Lee34667/PCB-KiCad-Project-1/adc.kicad_sch

## KiCad design adc.kicad_sch (2023-06-13)

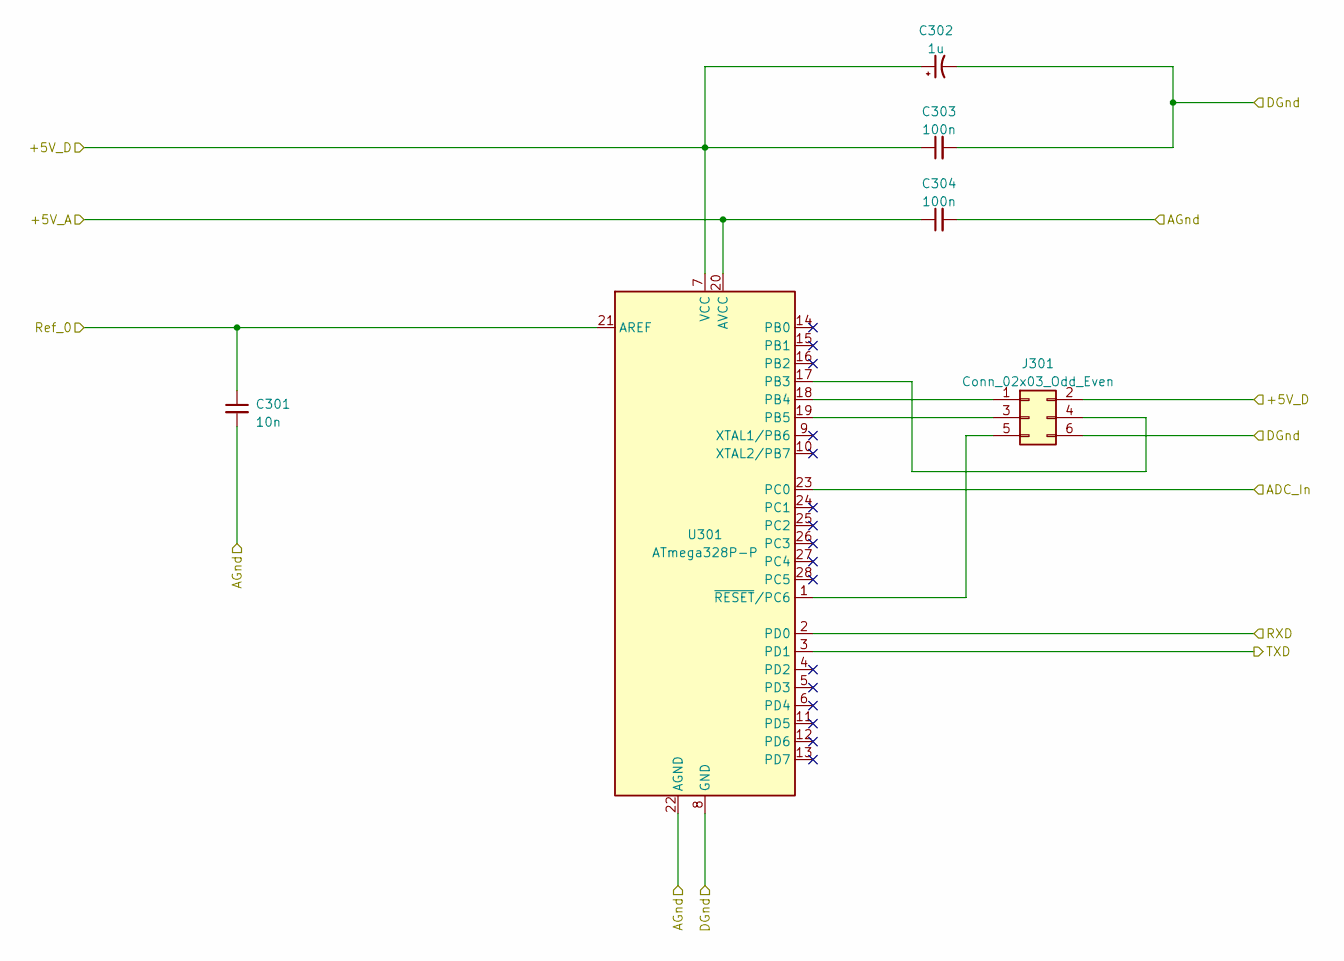
[picture p7: schematic adc.kicad_sch]

Parts:
C301: 10n; C_0805_2012Metric
C302: 1u; CP_EIA-3216-18_Kemet-A
C303, C304: 100n; C_0805_2012Metric
J301: Conn_02x03_Odd_Even; IDC-Header_2x03_P2.54mm_Vertical
U301: ATmega328P-P; DIP-28_W7.62mm

Connections:
+5V_A: C304.1, U301.20 (AVCC)
+5V_D: C302.1, C303.1, J301.2, U301.7 (VCC)
ADC_In: U301.23 (PC0)
AGnd: C301.2, C304.2, U301.22 (AGND)
DGnd: C302.2, C303.2, J301.6, U301.8 (GND), U301.22 (AGND)
unnamed: J301.1, U301.18 (PB4)
unnamed: J301.3, U301.19 (PB5)
unnamed: J301.4, U301.17 (PB3)
unnamed: J301.5, U301.1 (~RESET/PC6)
RXD: U301.2 (PD0)
Ref_0: C301.1, U301.21 (AREF)
TXD: U301.3 (PD1)
