Lee34667/PCB-KiCad-Project-1/power.kicad_sch

## KiCad design power.kicad_sch (2023-06-13)

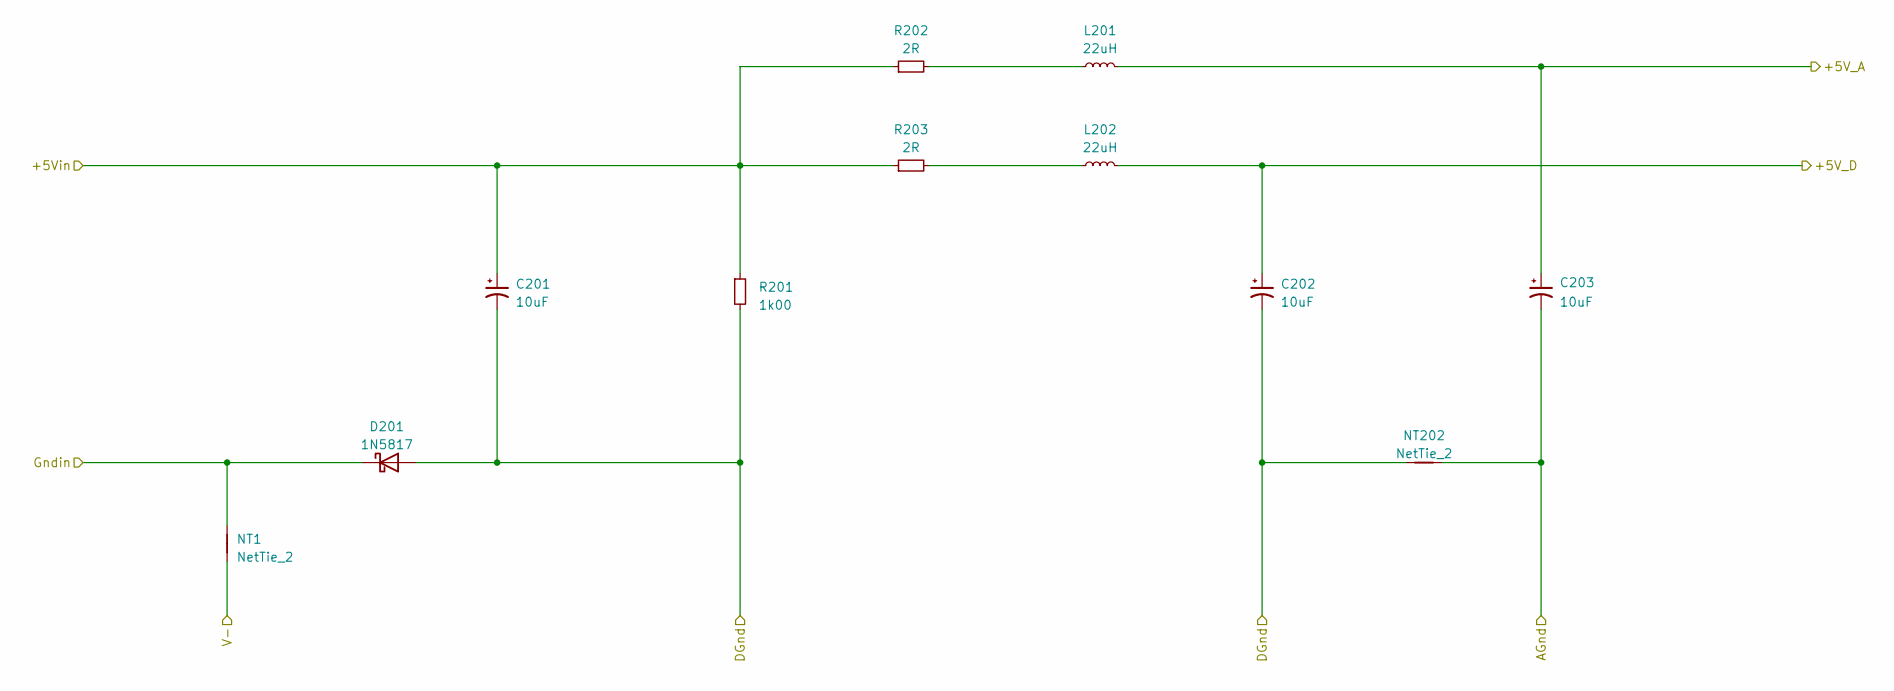
[picture p8: schematic power.kicad_sch]

Parts:
C201, C202, C203: 10uF; CP_EIA-3216-18_Kemet-A
D201: 1N5817; D_DO-41_SOD81_P10.16mm_Horizontal
L201, L202: 22uH; L_1210_3225Metric
NT1, NT202: NetTie_2; NetTie-2_SMD_Pad2.0mm
R201: 1k00; R_0805_2012Metric
R202, R203: 2R; R_0805_2012Metric

Connections:
+5V_A: C203.1, L201.2
+5V_D: C202.1, L202.2
+5Vin: C201.1, R201.1, R202.1, R203.1
AGnd: C203.2, NT202.2
DGnd: C201.2, C202.2, D201.2 (A), NT202.1, R201.2
Gndin: D201.1 (K), NT1.2
unnamed: L201.1, R202.2
unnamed: L202.1, R203.2
V-: NT1.1
