Lee34667/PCB-KiCad-Project-1/sens_amp.kicad_sch

## KiCad design sens_amp.kicad_sch (2023-06-13)

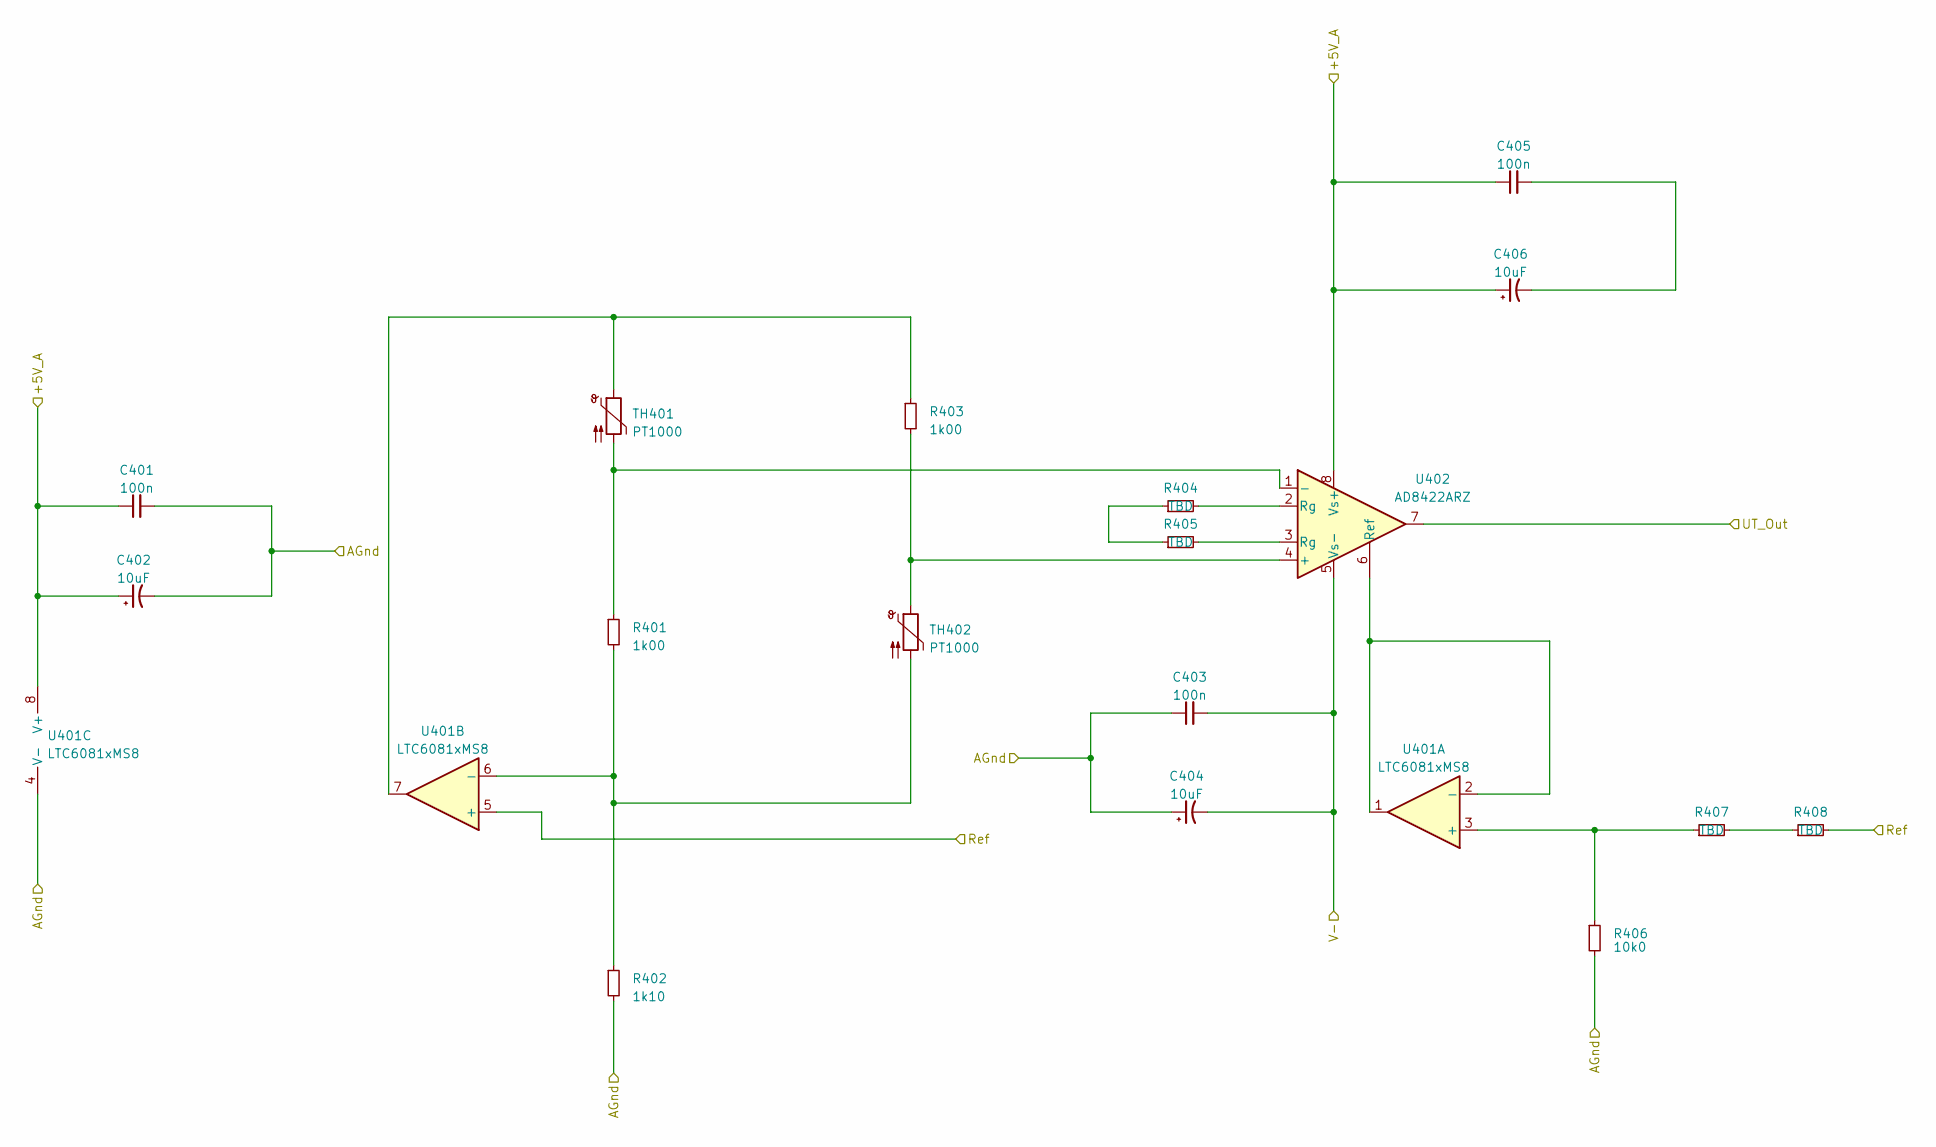
[picture p9: schematic sens_amp.kicad_sch]

Parts:
C401, C403, C405: 100n; C_0805_2012Metric
C402, C404, C406: 10uF; CP_EIA-3216-18_Kemet-A
R401, R403: 1k00; R_0805_2012Metric
R402: 1k10; R_0805_2012Metric
R404, R405, R407, R408: TBD; R_0805_2012Metric
R406: 10k0; R_0805_2012Metric
TH401, TH402: PT1000; R_0805_2012Metric
U401: LTC6081xMS8; SOIC-8_3.9x4.9mm_P1.27mm
U402: AD8422ARZ; SOIC-8_3.9x4.9mm_P1.27mm

Connections:
+5V_A: C401.1, C402.1, C405.1, C406.1, U401.8 (V+), U402.8 (Vs+)
AGnd: C401.2, C402.2, C403.1, C404.1, R402.2, R406.2, U401.4 (V-)
unnamed: C405.2, C406.2
unnamed: R401.1, TH401.2, U402.1 (-)
unnamed: R401.2, R402.1, TH402.2, U401.6 (-)
unnamed: R403.1, TH401.1, U401.7
unnamed: R403.2, TH402.1, U402.4 (+)
unnamed: R404.1, R405.1
unnamed: R404.2, U402.2 (Rg)
unnamed: R405.2, U402.3 (Rg)
unnamed: R406.1, R407.1, U401.3 (+)
unnamed: R407.2, R408.1
unnamed: U401.1, U401.2 (-), U402.6 (Ref)
Ref: R408.2, U401.5 (+)
UT_Out: U402.7
V-: C403.2, C404.2, U402.5 (Vs-)
